gcallipo/RadioDSP-Pico/obsolete/README.MD

This section includes older versione, but usefull because it uses different type of output including raw PWM output.
