gcallipo/RadioDSP-Pico/obsolete/RadioDSPPico_schematic_New.pdf

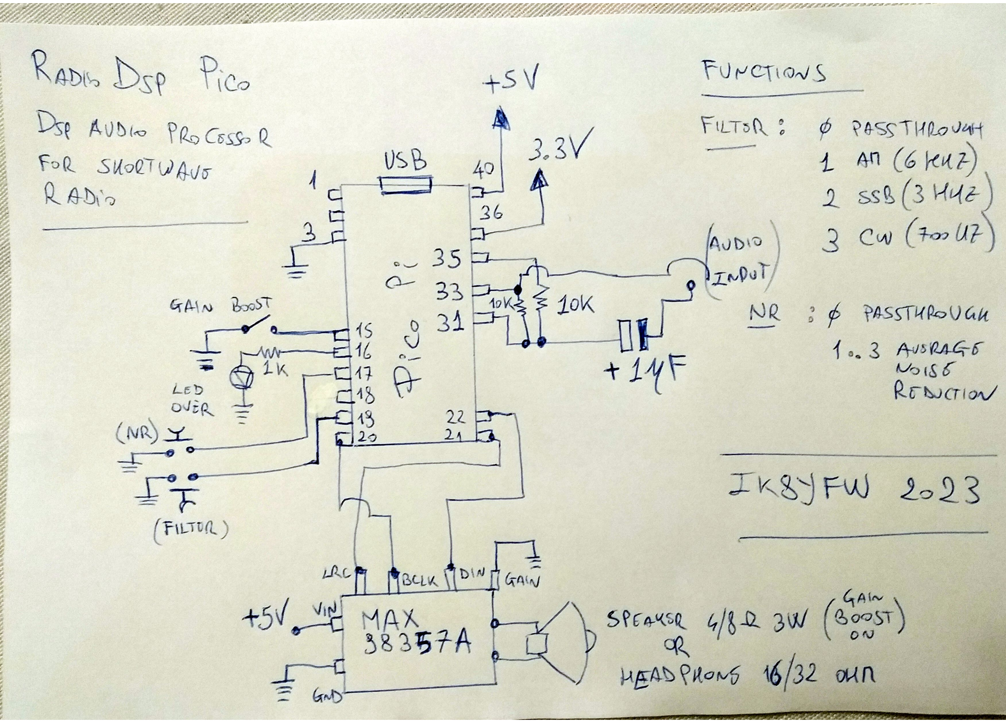
[picture p1: figure]
