gcallipo/RadioDSP-Pico/PicoPi-AudioBoard-Schematic.jpg

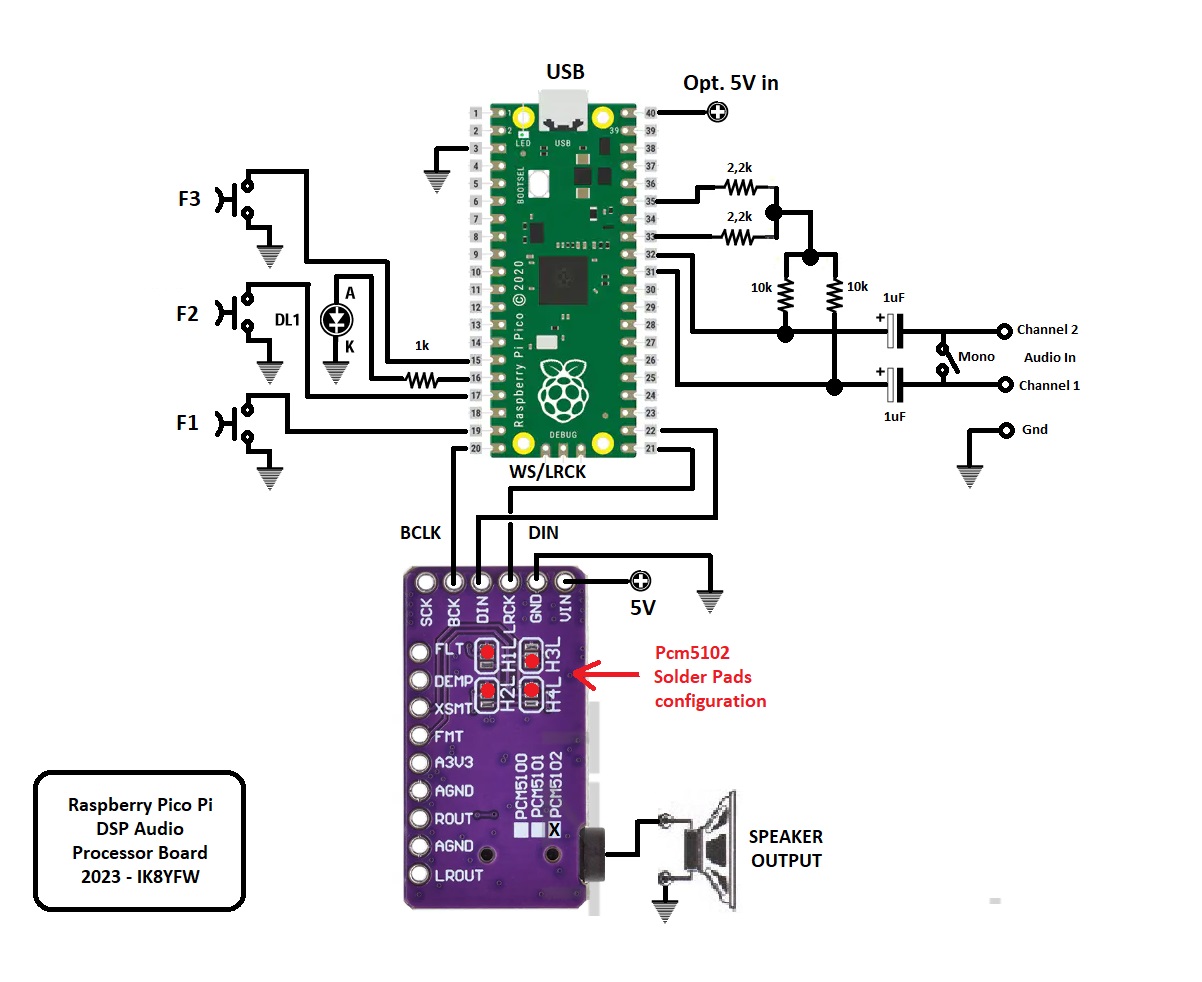
PicoPi-AudioBoard-Schematic.jpg
