gcallipo/RadioDSP-Pico/HowToSetupAndCompile_SimpleAudioFilter09.pdf

# Setup Arduino IDE

Open the preferences...

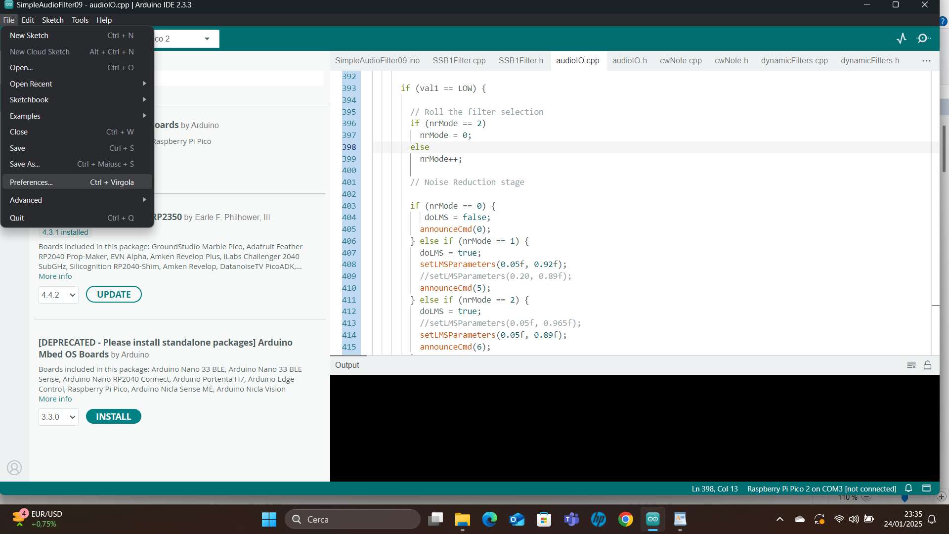
[picture p3: figure]

Select "Settings"

1

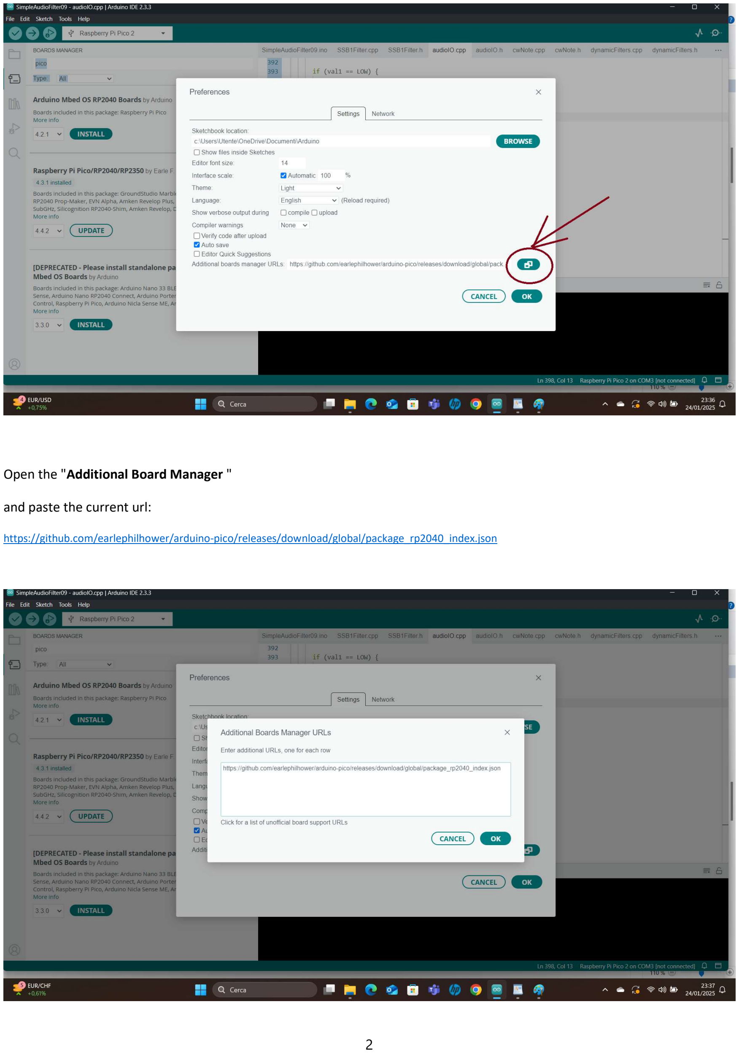
[picture p4: page 2]

Open the "Additional Board Manager "

and paste the current url:

https://github.com/earlephilhower/arduino-pico/releases/download/global/package_rp2040_index.json

2

Then ...

open the Boards Manager:

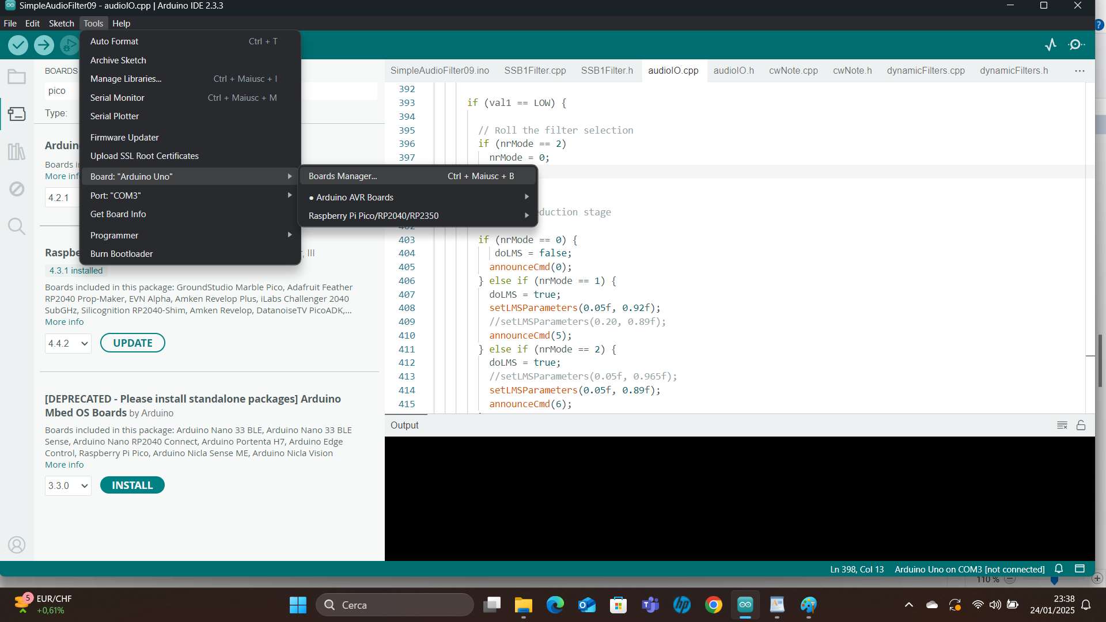
[picture p5: figure]

Install the : " Raspberry Pi Pico/RP2040/RP2350 by Earle F. Philhower, III "

3

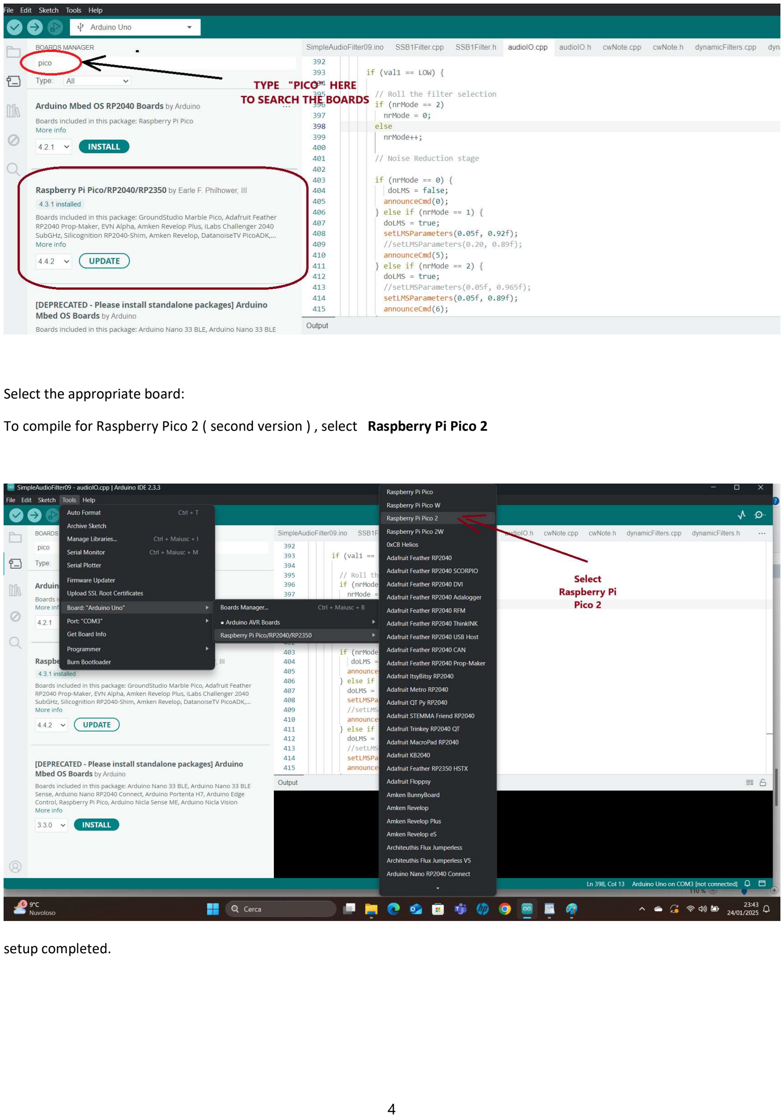
[picture p6: page 4]

Select the appropriate board:
To compile for Raspberry Pico 2 ( second version ) , select Raspberry Pi Pico 2

setup completed.

4

# Let's compile the source

Open the link: https://github.com/gcallipo/RadioDSP-Pico

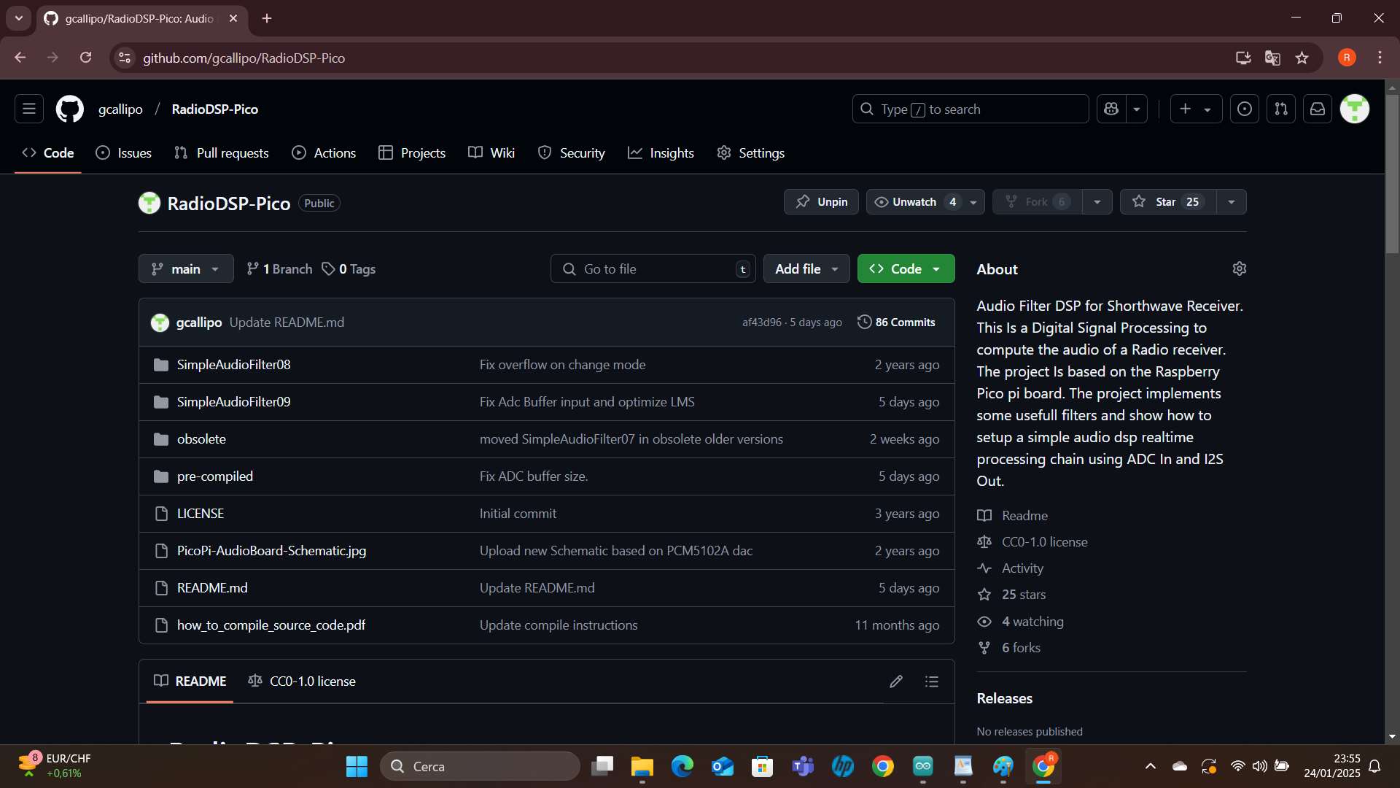
[picture p7: figure]

Download the full project as ZIP:

5

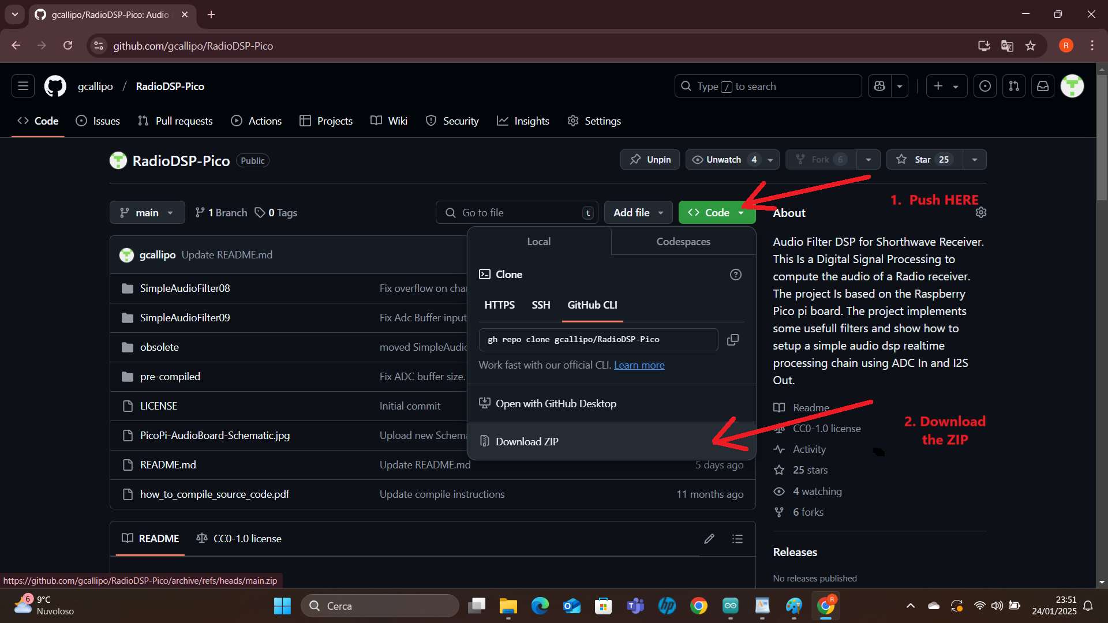
[picture p8: figure]

Unzip the download file: RadioDSP-Pico-main.zip

Open the Project : SimpleAudioFiler09

6

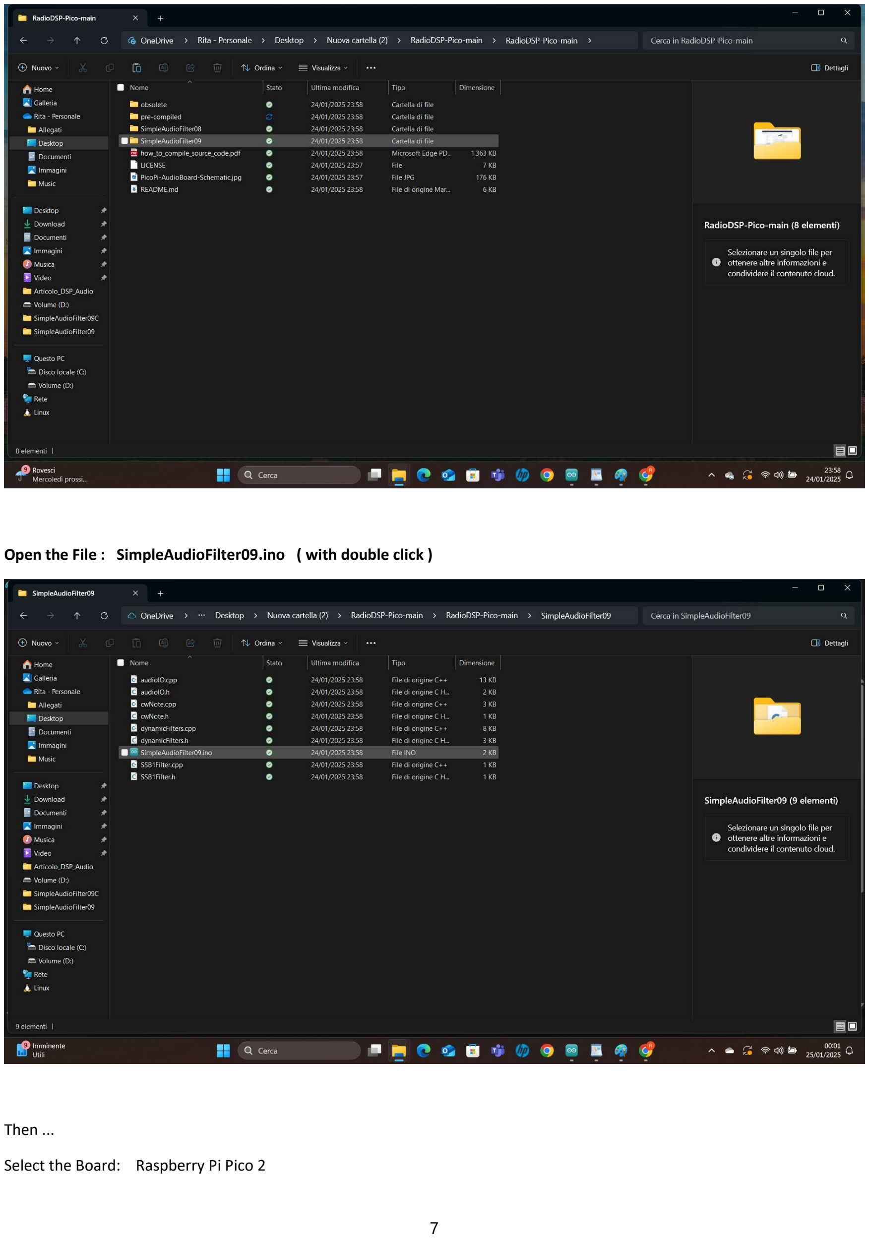
[picture p9: page 7]

Open the File : SimpleAudioFilter09.ino ( with double click )

Then ...
Select the Board: Raspberry Pi Pico 2

7

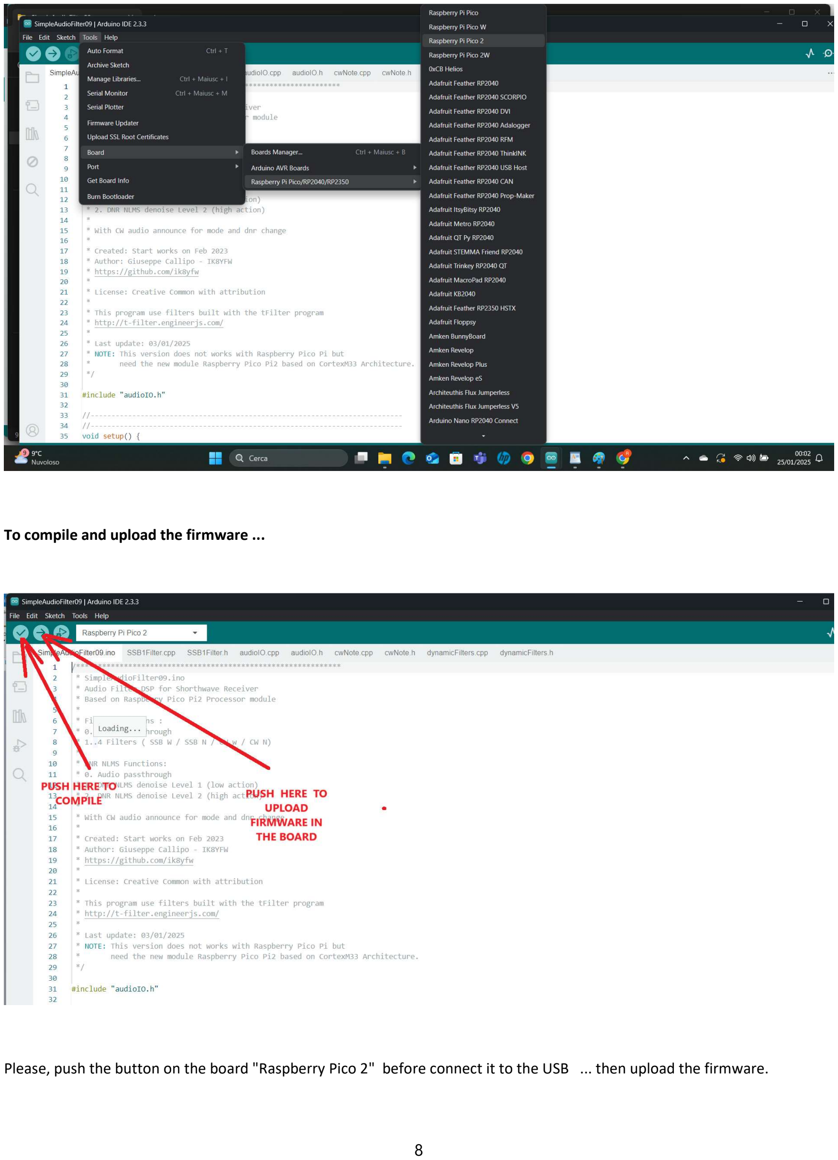
[picture p10: page 8]

To compile and upload the firmware ...

Please, push the button on the board "Raspberry Pico 2" before connect it to the USB ... then upload the firmware.

8

That's all folks.

9
