gcallipo/RadioDSP-Pico/how_to_compile_source_code.pdf

How to compile the source SimpleAudioFilter08.

Test done with: Arduino ide 2.3.0 and earlephilhower/arduino-pico plugin v. 3.7.0

Date: 12 Feb. 2024

Download the latest sources from github:

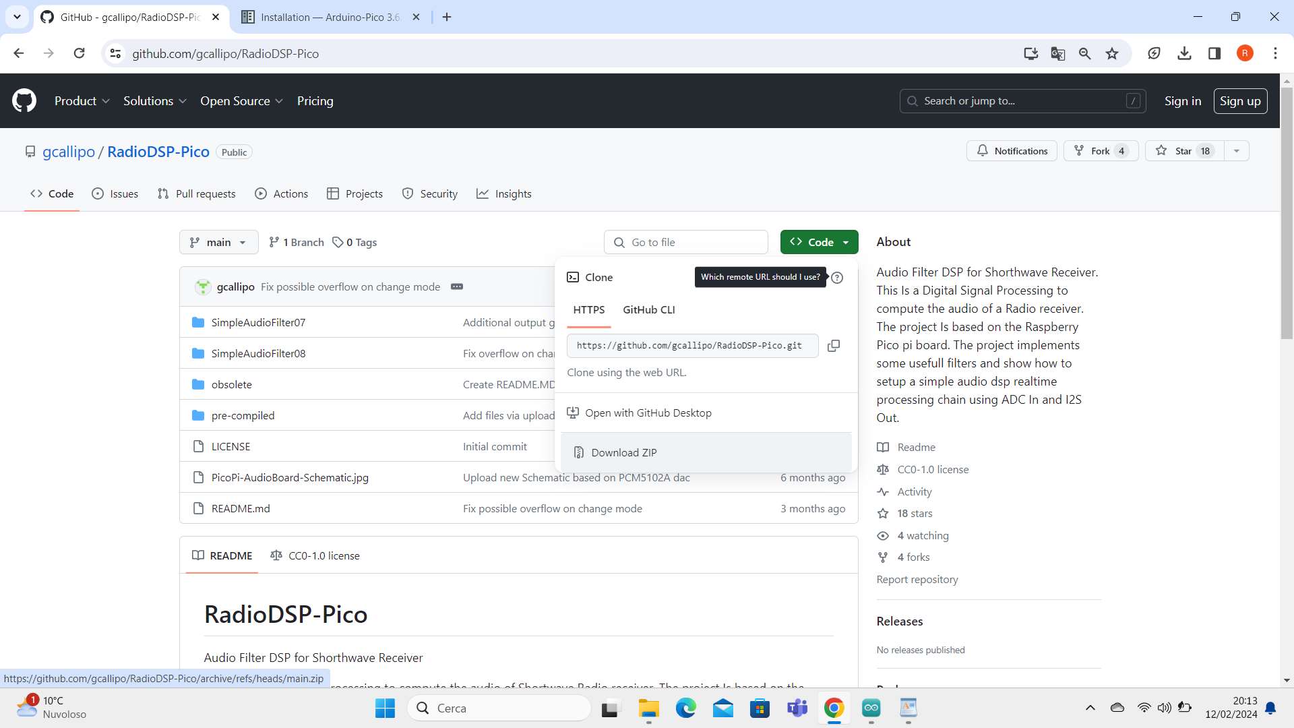
[picture p11: figure]

To download click on <> Code green button and select "Download"

Save in a directory the zip and unzip all:

1

Install the earphillover Arduino core pico, first add the additional source plugin frm preferences:

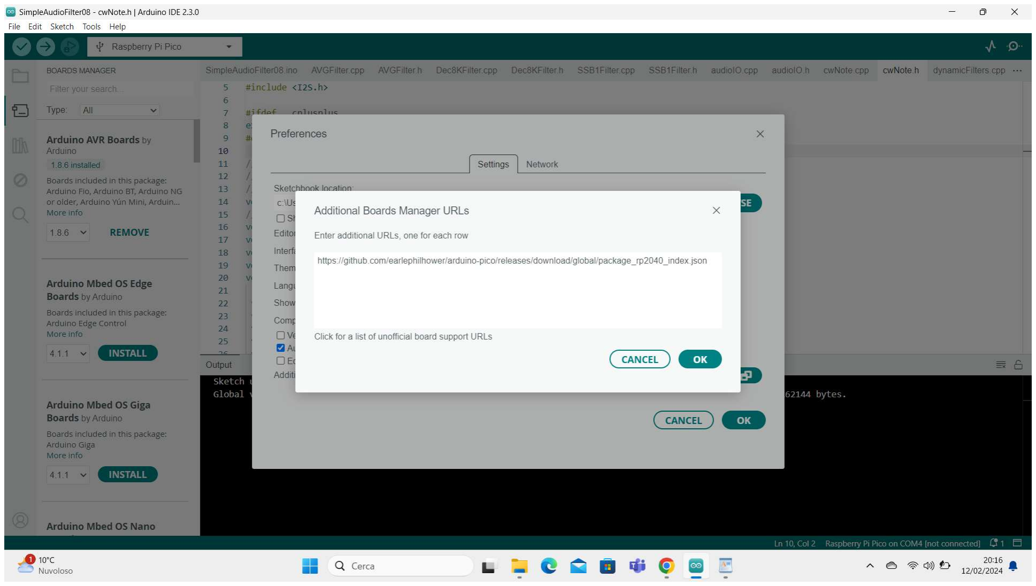
[picture p12: figure]

Next open the BoardManager:

2

and type the word: Pico

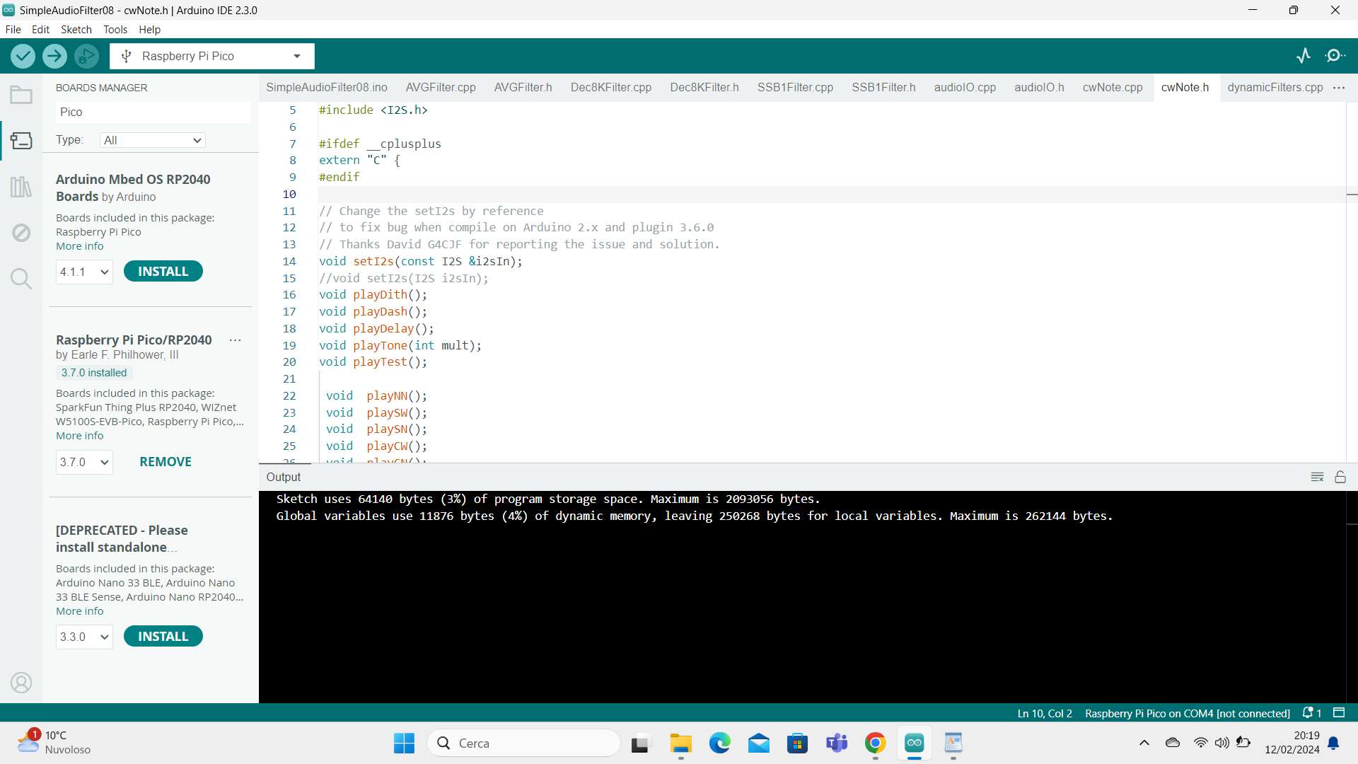
[picture p13: figure]

then select and install the plugin: "RaspBerry Pico..." by Earl Phillower ... Now your IDE is ready to compile the source.

Open the Project: "SimpleAudioFilter08"

Make sure to select the right Board version:

3

And Compile.

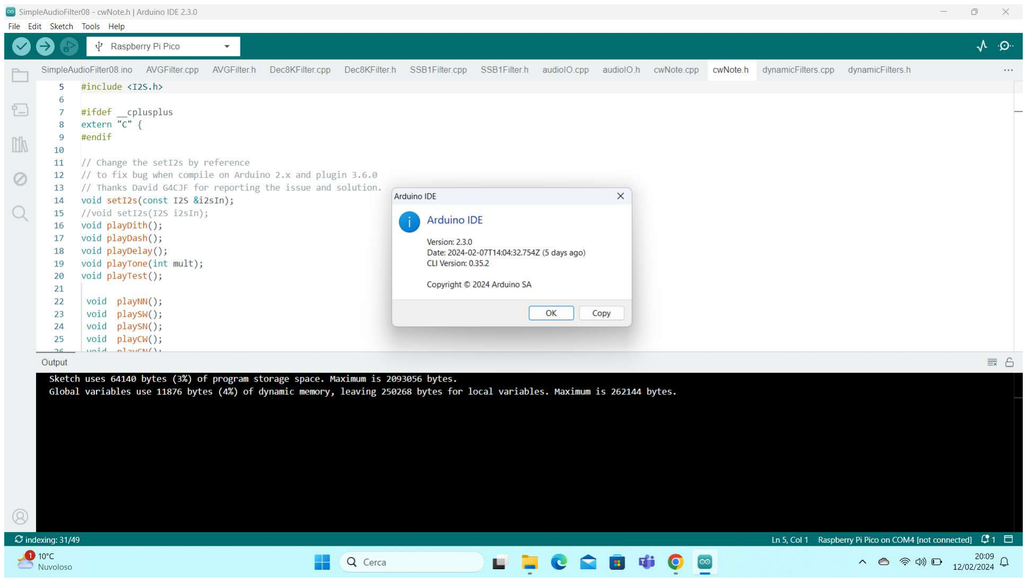
[picture p14: figure]

4
