gcallipo/RadioDSP-Pico/(threads)

Thread 2 (2023-01-15):

Measured BW of the filter differs from the programmed settings.

nezumi-tech, 2023-01-15:
I assembled the circuit following the instructions and measured the characteristics of the filter with audio spectrum analyzer.
As a result, I found that the measured filter characteristics differed from the programmed settings.

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

We can see that the attenuation of the filter (about -40dB) is correct and differs only in frequency.
Why are the filter frequencies different between settings and measurements?

gcallipo, 2023-01-15:
Fine ! Thanks for the tests.

I think that the delay to performs the  calculatuon at the sample rate of 48 kHz Is the cause of the error, I think,  of you check the last filter, the cw the error Is less than the other.

Then a First test Is to decrease the taps Number of the am and ssb filters , but ... Better approach, It ti decimate more before filter.

Please could performs the same testa with the First version? The version that use the 8 bit in ADC? Because in that version I used more decimation in filtering session.

Please take the same measure, to understood if using a decimation factor by 4 or more helps the filtering.

Another try Is to esclude the pre /post DNR filter , because when we concatenate two fir filters in cascade the results Is not overrides but It Will be changed.

Make this two experiments
1. Check the measurements with the First vetsion
2. Check the measurements with the second version, but excludes the DNR filter (the AVG) .

I cannot make testa at the moment, mybe the next weekend.

Thanks.
G.
--
Inviato da Libero Mail

nezumi-tech, 2023-01-15:
Thanks. I made additional experiments.

## Result of first version
I think the measurements are more closer to settings, but the difference remains.

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

## Result of second version without AVG filter
I think there is almost no difference compared to with AVG filter.

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

gcallipo, 2023-01-15:
Ok thanks, It Is more clear.

In the First version I did some experiments to compensate a bit the filter, and you can see Better results.

The idea was to evaluate the filter using a base sample rate smaller than the original One. I can explain Better : evaluate the filter using a sample rate of 44 (or less) instead of 48 for am and ssb.  For the Cw use 10 (or less) kHz instead of 12 kHz , in this way we can compensate a bit the error in the eleboration chain.

The challenge here Is to gain the Better results with this small processor, ofcorse using Cortex m4 of h7 It  Is simple,  but here we have a small Cortex m0 processor but I'm sure that we can obtains also acceptable results. The next steps Will be to move the output to I2S to decrease the PWM Noise.

What program do you use to performs the spectral analisys ?

It Is interesting , normally I used the spectroid for android but It Is not extremaly efficient.

Thanks to interesting in the project.
Best 73 de Giuseppe.
--
Inviato da Libero Mail

nezumi-tech, 2023-01-16:
Thanks. I will try adjusting sampling rate to correct filter.

I use WeveGane as sweep signal generator,
http://web.archive.org/web/20171102031127/http://efu.jp.net/soft/wg/wg.html

and

nezumi-tech, 2023-01-16:
I tried overclocking the pico to 250MHz with earlephilhower/arduino-pico Arduino core.
https://github.com/earlephilhower/arduino-pico

Then, I achieved 0-4kHz filter BW with 0-6kHz AM/SSB filter mode, it was 0-2kHz BW before.
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

The overclocked frequency (250MHz) is 2 times higher than default (125 or 133MHz).
So I think that the sampling frequency is lowering due to the processing time.

I will make another pull request to migrate the Earlephilhower's Arduino core.

gcallipo, 2023-01-16:
Yes that was the problem.
Now and idea also could be to move the project to the original Pico SDK and try to compensate the sampling frequency with a small o different kind of filter.

But your experimentation was really usefull.

Thanks .
--
Inviato da Libero Mail

gcallipo, 2023-01-21:
Please, check the filters now, I;ve updated the sample rate, from 48 to 24 khz and recalculate all filters, now the AM works at sample rate of 24 khz, the ssb works at sample rate of  12 khz (decimation by 2) and the CW works at sample rate of  6khz (decimation by 4 ), this is a starting point but I think that it works better.
If possible check the bandwidt now.

NOTE: I use the MBED updated at the new version 3.5.4.

nezumi-tech, 2023-01-21:
I measured your updated Filter and we can see that AM Filter has 6kHz BW.

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

Also, SSB filter has 4 kHz BW.

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

And, CW filter has about 300 to 1,500 Hz BW.

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

The frequency is quite similar, but it is seen that the performance of filter has degraded.  I think it is due to reduced number of taps.

nezumi-tech, 2023-01-21:
I added the feature to measure the sample rate. please see new pull request.

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

gcallipo, 2023-01-21:
Ok, I can see that the BW Is like the specification of filter, and this Is good, and now we have a real limit of elaboration.

The filter performance could be optimized , also, I think moving the output from PWM to I2S Digital output, I got a small max I2S amplifier and I Will try to change the output.

Also the filter could be optimized using more taps ofcorse.

Let's try with the overclocked processor.

Thanks for the test and support.
Ik8yfw.

Note:
For the I2S output I Will add a new project the SimpleFilter03 .
--
Inviato da Libero Mail

gcallipo, 2023-01-28:
Close current sub project.
Starting new experiments on SimpleAudioFilter06.

Closed 2023-01-28.

Thread 8 (2023-02-13):

The 8k decimation may be causing high frequency noise in SSB and CW filter.

nezumi-tech, 2023-02-13:
The 8k decimation may be causing high frequency noise in SSB and CW filter.

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
Figure 1 The frequency response in SSB filter mode.

I input the 10～4k Hz sweep sine wave to the filter and measure the frequency response. Then I found that there is high frequency noise in 5k to 8kHz. This noise is aliasing noise around 4k Hz nyquist frequency (sampling frequency 8kHz / 2).

I add post interpolation 0-4kHz filter with PR #7 .

nezumi-tech, 2023-02-13:
High frequency noise around 5~8kHz is very painful to the ear. But, the noise around 16kHz is almost harmless because it is upper edge of human audible bandwidth.

nezumi-tech, 2023-02-13:
Or, we can use fully 16kHz filters and don't use 8k decimation.
https://github.com/nezumi-tech/RadioDSP-Pico/compare/Delete8kDecimation
But, this change will make it difficult to design of narrow bandwidth filters such as SSB and CW.

gcallipo, 2023-02-13:
Yes correct this must be suppressed by the pre filter 8k because we done the decimation and It Is normal. Then we can adjust the actions of 8k LPF pre filter to eliminate that problem.

The decimation process helps to decrease of some db the Noise level from the ADC Input Signal, but Need of tuning at the pre filtering.

I think that we can recalculate the pre filter with more suppression.
--
Inviato da Libero Mail

gcallipo, 2023-02-13:
Yes also a post interpolation can helps , but try to cut some frequencies using the pre interpolation also.
This experimantation Is important because we Will use this filtering and decimation technic in the next project ( optimized sdr multimode Receiver )  with the Pico Pi.

Thanks for the effort that you Place in the project.

Ik8yfw

--
Inviato da Libero Mail

gcallipo, 2023-02-13:
No, we need the decimation, because the narrow filter works Better, and in the future project Will be the main process to works in multirate .

Then Better to use the decimator, we cannot delete It mybe recalculate It a bit narrow not 8k but cut at 5 but with a -60 db.
--
Inviato da Libero Mail

gcallipo, 2023-02-13:
No please don't cut the decimation we Need as base for the next project where working in multirate Is normal, in the next optimized sdr Receiver we Will use the multirate to process data as needs and to create good narrow filters with the small Pico . Then we need It. Mybe we can correct the 8k pre filter to cut before or add an interpolation post filtering.
--
Inviato da Libero Mail

nezumi-tech, 2023-02-13:
I did not understand your objective, but I realized that you are creating this project for future Pi Pico SDR radio project.
Can I make the standalone lowcost audio DSP system for analog radios such as FT-818 with your (or my forked) code?
I think there are some differences in design concepts between a part of SDR radio and standalone system.

And I think post interpolation filter is needed to cutout image.
https://www.ni.com/docs/ja-JP/bundle/labview-digital-filter-design-toolkit-api-ref/page/lvdfdtconcepts/dfd_interpolation.html

gcallipo, 2023-02-13:
Yes you are right, the primary objective Is to make the cheap and stand Alone filtering, i think that the decimation can help because allow to process more narrow filtering. Otherwhise you must avoid It but I think that Will be some problems on real near filtering.

The other side Is to reuse this experiences on next project, the Pico have not DSP hw estention and if we correct the decimation problema I think that Will be simple to make Better narrow filtering at 8k or less for CW .

Then yes filter project, but if possible, to found the best results on cw and ssb narrow.

--
Inviato da Libero Mail

gcallipo, 2023-02-13:
I think that missed the interpolation filter, I Will check for It as soon as possible, and I think that this can solve the uneanted signals problem.
--
Inviato da Libero Mail

gcallipo, 2023-02-13:
Just as info, the interpolation filter will works at 8khz sample rate and must cut at 4khz or less.

I will try Is as soon as possible.
--
Inviato da Libero Mail

gcallipo, 2023-02-18:
hello, I just added another SimpleAudioFilter08 project that uses a dynamic filter calculation algorithm according to the windowed sinc technique.  Listening is not bad, the filters are defined only by indicating the type ( low pass, High pass , passand or notch ), the Windows characteristic ( backman hemming etc ... ) and the sampling frequency.  This routine works in double to improve the calculation and then converts the coefficients to integers to allow faster processing.  The calculation of the coefficients is done in the second core in order not to alter the audio.  With a little tuning on the taps I think you can get good results.  I hope it can be useful to you.  Best 73 Ik8yfw Giuseppe
--
Inviato da Libero Mail

nezumi-tech, 2023-02-18:
Awesome! I think standalone calculation of filter taps is useful to tune the filter in use.

Closed 2023-02-14.
