gcallipo/RadioDSP-Pico/SimpleAudioFilter09/AVGFilter.cpp

/************************************************************* 
 *  SimpleAudioFilter02.ino
 * Audio Filter DSP for Shorthwave Receiver
 * Functions:
 * 0. Audio passthrough 
 * 1. DNR Average denoise 
 * 2. DNR + DNF Average Denoise + LMS Filter (NB & Beat eliminator)
 * 3. AM/SSB filter 6000 kHz + DNR low level
 * 4. SSB filter    3000 kHz + DNR medium level
 * 5. CW  filter    700  Hz  + DNR low level
 * 
 * 
 * 
 * Created: Nov 2022
 * Author: Giuseppe Callipo - IK8YFW
 * https://github.com/ik8yfw
 * 
 * License: Creative Common with attribution 
 * 
 * This program use filters built with the tFilter program
 * http://t-filter.engineerjs.com/
 * 
 * Last update: 02/01/2022
 */

#include "AVGFilter.h"

void AVGFilter_init(AVGFilter* f, int filterDepth) {
  int i;
  for(i = 0; i < f->FilterDepth; ++i)
    f->history[i] = 50;
  f->last_index = 0;
  f->FilterDepth = filterDepth;
}

void AVGFilter_put(AVGFilter* f, int input) {
  f->history[f->last_index++] = input;
  if(f->last_index == f->FilterDepth)
    f->last_index = 0;
}

int AVGFilter_get(AVGFilter* f) {
  long long acc = 0;
  for(int i = 0; i < f->FilterDepth; ++i) {
    acc += (long long)f->history[i];
  };
  acc = (long long)(acc/f->FilterDepth);
  
  return (int)acc;
}
