gcallipo/RadioDSP-Pico/(commit log)

2022-11-10 SimpleAudioFilter01 first commit
    First commit of realtime dsp filter example with 3 modes : passthrough, SSB 3kHz filter and 500 Hz CW filter.
2022-11-13 Project update
    Update project with filter improved and added a simple DNR
2022-11-27 Filter improvement
    Filter improvement
2022-11-27 Add schematic
2022-12-08 Filtering upgrade
    I added a new filter for AM/SSB reception and also some improvement to other filters.
2023-01-02 Full 12 bit AD version
    This is the upgraded version of dsp filter with the full 12 bit ADC resolution
2023-01-12 Set GPIO 23 HIGH to keep SMPS PWM mode.
    RPi Pico has onboard SMPS (DC-DC converter) for power management. The SMPS has PWM and PFM mode. Unfortunately, PFM mode produces audio noise. We can keep SMPS PWM mode by setting GPIO 23 HIGH.
    [SimpleAudioFilter02.ino]
2023-01-21 Add files via upload
    Updaed filters and sample rate
2023-01-21 Add the feature to measure the sample rate.
    Uncomment #define MeasSampleRate to enable the feature to measure the sample rate.
    It loops audioIO_loop() for 1,000,000 times to measure processing time, then it calculates the sample rate.
    Reference : https://github.com/earlephilhower/arduino-pico/discussions/1070
2023-01-28 New experimental filter ADC + I2S
    Test on experimental Filters using aearlephilhower/arduino-pico plugin
    with ADCInput and I2S output on MAX98357A digital amplifier.
2023-02-10 Convert a 12-bit ADC reading to a 15-bit data.
    The adcIn.read() generates 12bit data. I modify the code to convert a 12-bit ADC reading to a 15-bit data by multiplying by 8. It can enables us to get more big output sound and more better dynamic range. According to my test, just converting 12-bit to 16-bit by multiplying by 16 causes noise when over-ranging. The one bit may be remaining for filtering.
    [SimpleAudioFilter06.ino]
2023-02-11 New Version use MAX98357A I2S amplifier
    New Version use MAX98357A I2S amplifier and new filters
2023-02-11 Change the over-range LED to the built-in LED.
2023-02-11 Change ADC OVER_RANGE from 150 to 2000
    The 12bit ADC will produce 0 ~ 4095 value and we minus 2048 then we get -2048 ~ 2047 value. So, we can set OVER_RANGE threshold to 2000 to use full dynamic range of ADC.
2023-02-11 Change gainAudio for speaker from 25 to 8.
    The 12bit ADC produces the 12bit data. I think greater than 2^4 = 16 times of gain is useless for 16-bit DAC, and it just produces noise. So, I change the gainAudio for speaker from 25 to 8.
    Additionally, I move the gaining process from the after filtering to before. It will improves dynamic range due to fully use of 16-bit precision filter.
    [audioIO.cpp]
2023-02-11 Delete pre-gaining before filtering.
    Pre-gaining before filtering is no longer necessary.
    [audioIO.cpp]
2023-02-11 Remove unnecessary ADC_BIAS corrections
    The 16-bit DAC outputs variables of type int16_t (-2048 ~ 0 ~ +2047). The ADC_BIAS corrections is unnecessary because we already corrected its bias before filtering at line 127.
    > newSample = newSample - ADC_BIAS -ADC_BIAS_SHIFT;
    [audioIO.cpp]
2023-02-11 Apply "Auto Format" of Arduino IDE.
2023-02-12 Correct gain and input safe level
    Adjusts the gain max and min amplification (can be adapt by user) and set the input overranges
    to a safe level for ADC input. Also the led over indicator can be adjusted for onboard or external
    LED to allow the external box installation.
    [audioIO.cpp]
2023-02-13 Add post interpolation 0-4kHz filter
    The 8k decimation may be causing high frequency noise in SSB and CW filter. I add post interpolation 0-4kHz filter to cutout this noise.
    [audioIO.cpp]
2023-02-13 Add new schematic for MAX Amplifier
2023-02-14 Compensate the decimated filters loss
2023-02-18 Additional output gain for filtering compensation
2023-02-18 Add new Fir kernel for dynamic FIR calculator
    Add new Fir kernel for dynamic FIR calculator.
    Now it is simple to add sinc windowed filters with dynamic calculation embedded into the code.
    The Fir coefficients are calculated in double presition and then converted to int16 to make possible
    the Pi pico realtime filtering.
2023-07-07 Add cw announce
    Add cw announce when change mode and dnr and some fix
    [SimpleAudioFilter08.ino, audioIO.cpp, cwNote.cpp, cwNote.h]
2023-08-13 Upload new Schematic based on PCM5102A dac
    Upload new Schematic based on PCM5102A dac.
    This is immune to interferences and noise.
2023-11-24 Fix overflow on change mode
    // Change the setI2s by reference
    // to fix bug when compile on Arduino 2.x and plugin 3.6.0
    // Thanks David G4CJF for reporting the issue and solution.
    [cwNote.cpp]
2023-11-24 Fix possible overflow on change mode
    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
2025-01-12 New DNR need Pico 2
    New Firmware that implements the LMS dnr, need the Pico 2 processor.
2025-01-19 Fix Adc Buffer input and optimize LMS
    The buffer input for ADC was changed to reflect the BUFFER_SIZE of 128 samples, was 16.
    [audioIO.cpp]
2025-01-19 Fix ADC buffer size.
    update the precomiled binary
2025-01-24 How to Setup for SimpleAudioFilter09
    Compile for Raspberry pico pi 2
2025-03-05 Add average filter to compensate adc noise
    Add average filter to compensate adc noise
    [AVGFilter.cpp, AVGFilter.h, audioIO.cpp]
2025-05-05 Notice on Arduino plugin fix
    Notice on Arduino plugin ADC Input fix
